AntonPower/Temp_Hum_Sensor_Cube/README.md

# Temp. Hum. Sensor Cube

Firmware für einen ESP-12 mit TH06/Si7006-Sensor. Der Cube misst Temperatur und
Luftfeuchtigkeit, speichert den Verlauf der letzten 7 Tage und zeigt die Temperatur auf
Tastendruck 10 s lang über eine RGB-LED an.

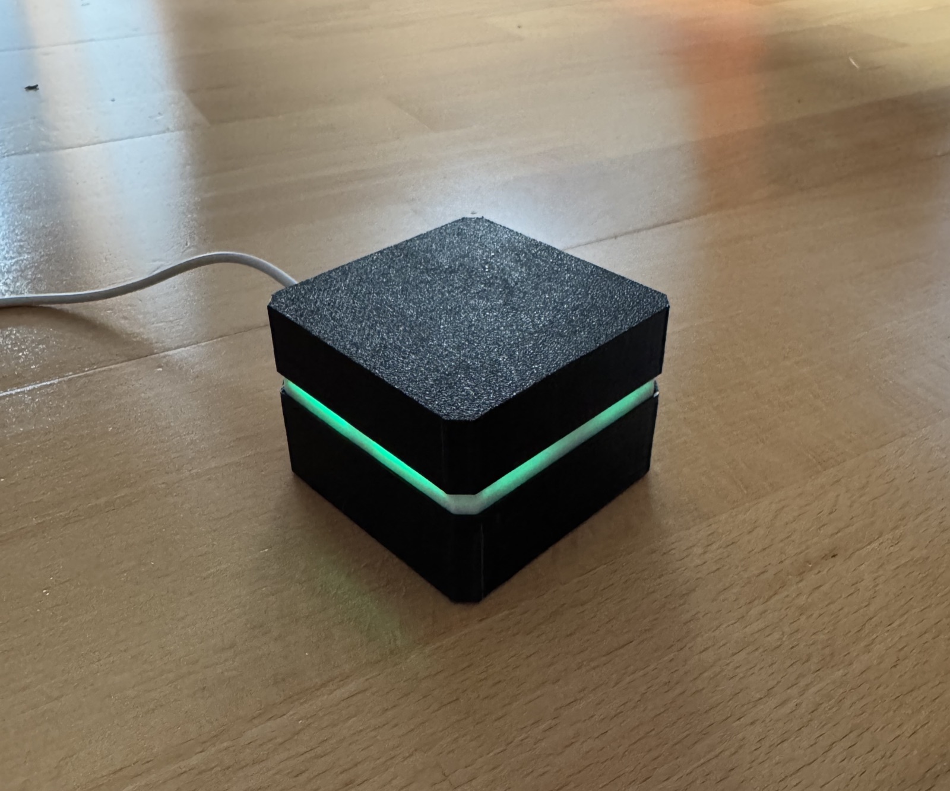
[picture p1: bilder/Cube_fertig_front.jpg]
Fertiger Sensor Cube


## Hardware

| Ordner | Inhalt |
|---|---|
| [`SCH_and_PCB/`](SCH_and_PCB) | Schaltplan als PDF, Stückliste der Platine (BOM, CSV) und Gerber-Dateien der Platine V1.0 zum Bestellen (EasyEDA) |
| [`3D parts/`](3D%20parts) | Gehäuse in drei Teilen zum Drucken (`Sensor_Cube_bot.stl`, `Sensor_Cube_middle.stl`, `Sensor_Cube_top.stl`) und das 3D-Modell der bestückten Platine (`3D_Model _V1.0 PCB.obj`) |
| [`bilder/`](bilder) | Fotos der Platine, vom Zusammenbau und vom fertigen Cube |

Das EasyEDA-Projekt mit Schaltplan und Platinenlayout ist öffentlich auf OSHWLab:
[oshwlab.com/antonpower48/temp_hum-sensor](https://oshwlab.com/antonpower48/temp_hum-sensor)

Die Platine hat einen ESP-12, den Sensor TH06/Si7006, eine RGB-LED, einen Taster,
einen Spannungsregler AMS1117-3.3 und eine Micro-USB-Buchse zur Versorgung. Die
vollständige Bauteilliste steht in der BOM.

Für die Gerber-Dateien den Ordner `Gerber_…` als ZIP packen und beim Platinenhersteller
hochladen, eine Anleitung steht in `How-to-order-PCB.txt`.

### Diode in der roten LED-Leitung (nur V1)

Bei der Platine V1 muss eine Diode 1N4148 (oder 1N400x) nachträglich eingelötet werden,
in Reihe in der roten Leitung zwischen LED und GPIO12, Kathode (Ring) zum ESP.

Warum: Die Anoden der RGB-LED hängen über je 100 Ω an 5 V, die LED ist LOW-aktiv. Zum
Ausschalten legt der ESP den Pin auf HIGH, das sind aber nur 3,3 V. Über der roten LED
bleiben so etwa 1,7 V, sie glimmt rot/orange, und GPIO12 bekommt dauerhaft Strom von den
5 V ab. Die Diode schluckt etwa 0,7 V, damit ist das Glimmen im Gehäuse nicht mehr zu
sehen und Rot wird kaum dunkler. Grün und Blau brauchen keine Diode, weil ihre
Flussspannung bei etwa 3 V liegt. An der Software ändert sich nichts.

### Teile für den Zusammenbau

Neben der bestückten Platine und den drei gedruckten Gehäuseteilen:

| Anzahl | Teil |
|---|---|
| 2 | Zylinderschraube mit Innensechskant M4 x 10 mm |
| 4 | Zylinderschraube mit Innensechskant M4 x 20 mm |
| 4 | Druckfeder 7/32" x 11/16" |
| 1 | Diode 1N4148 oder 1N400x (nur V1, siehe oben) |

| Teile vor dem Zusammenbau | Platine im Gehäuse, Federn im Deckel |
|---|---|
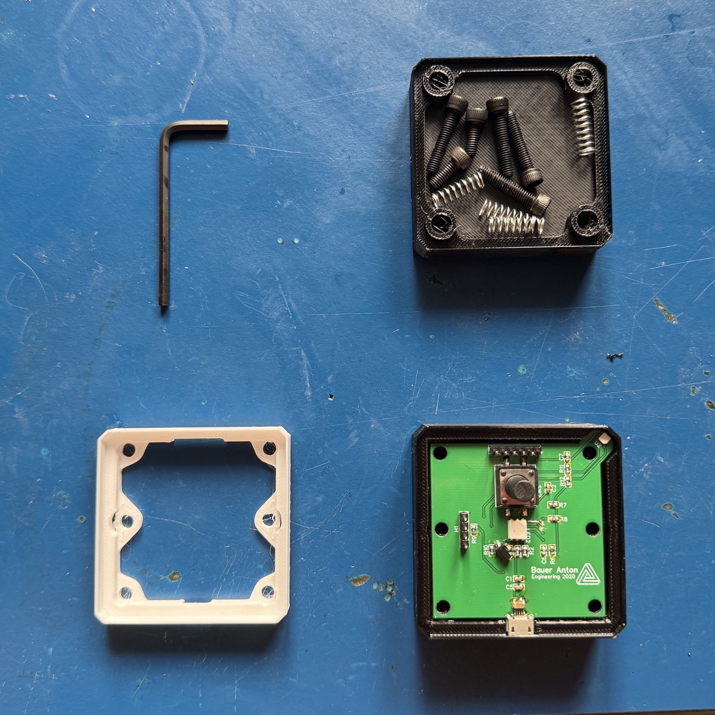
[picture p2: bilder/Cube_im_zusammenbau1.jpg]
Teile vor dem Zusammenbau
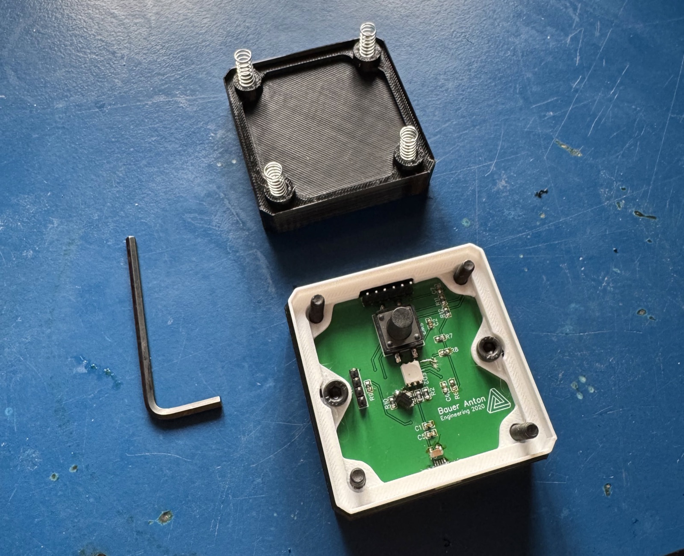
[picture p3: bilder/Cube_im_zusammenbau2.jpg]
Platine im Gehäuse
|  |  |

| Fertiger Cube | Fertiger Cube mit USB-Kabel |
|---|---|
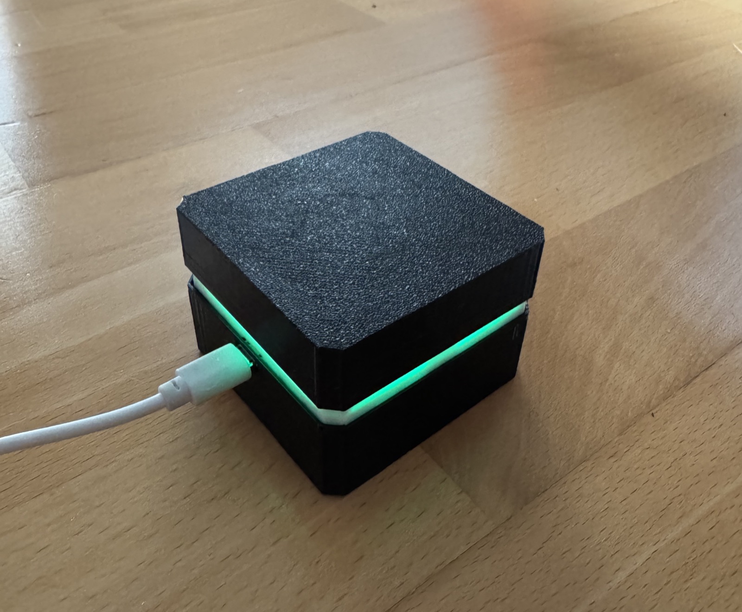
[picture p4: bilder/Cube_fertig_back.jpg]
Fertiger Cube mit USB-Kabel
| Fertiger Cube |  |

| Platine Vorderseite | Platine Rückseite | Platine mit LED |
|---|---|---|
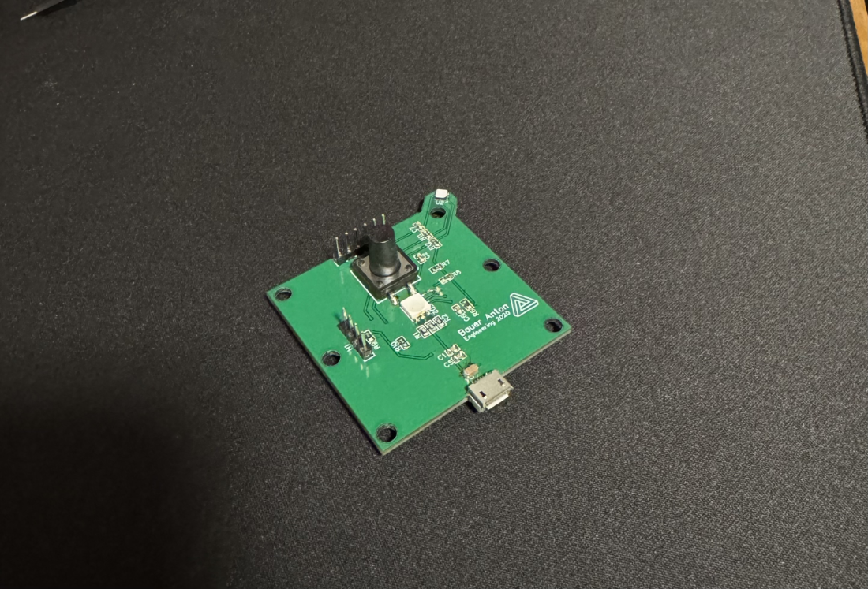
[picture p5: bilder/Board_front.png]
Platine Vorderseite
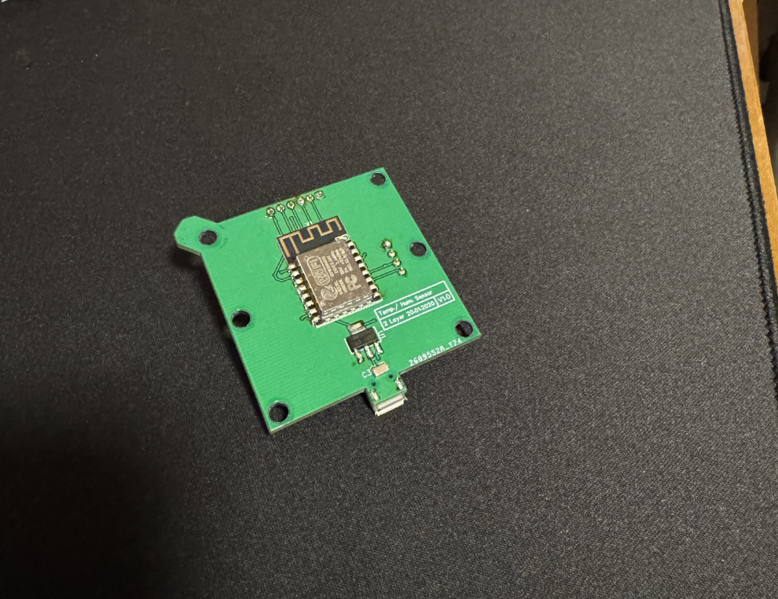
[picture p6: bilder/Board_back.png]
Platine Rückseite
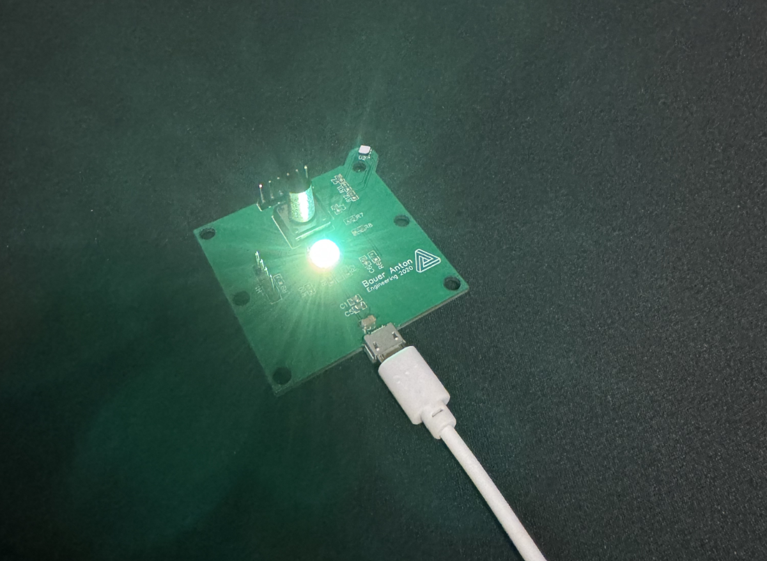
[picture p7: bilder/Board_led.png]
Platine mit leuchtender LED
|  |  |  |

## Bauen und Flashen

Das Projekt nutzt [PlatformIO](https://platformio.org/) in VS Code.

```sh
pio run                 # bauen
pio run -t upload       # flashen
pio device monitor      # serielle Ausgabe (115200 Baud)
```

## Pinbelegung

| Funktion | GPIO |
|---|---|
| I2C SDA / SCL (Sensor) | 4 / 5 |
| LED R / G / B | 12 / 14 / 16 |
| Taster (low-aktiv) | 13 |
| TM1637 CLK / DIO (V1 ungenutzt) | 2 / 0 |

## Stand

- [x] Messung über I2C, Ausgabe über Serial
- [x] LED-Farbverlauf und Taster (kurz drücken: Temperatur 10 s anzeigen, 2 s halten: Einstellungsmodus)
- [x] Einstellungsmodus per Browser
- [x] Verlauf der letzten 7 Tage und Stromsparen

## Einstellungen

Taster 2 s halten: Die LED blinkt langsam violett, und der Cube öffnet das eigene WLAN
`SensorCube` (Passwort `sensorcube`) mit der Seite unter `http://192.168.4.1`.
Dort Werte eintragen und speichern. Ein kurzer Druck oder nochmals 2 s halten beendet den Modus ohne Speichern, ebenso 5 Minuten
ohne geöffnete Einstellungsseite.

## Verlauf und Stromsparen

Der Cube bildet alle 10 Minuten einen Mittelwert, hält die letzten 7 Tage im RAM
und sichert sie stündlich in den Flash (LittleFS). Das WLAN bleibt dabei aus,
zwischen den Messungen schläft er im Light-Sleep, ein Tastendruck weckt ihn
sofort auf.

Beim Öffnen der Seite übernimmt der Cube die Uhrzeit des Handys. Kennt er sie beim
Sichern, weiß er nach einem Stromausfall, wie lange er aus war, sobald die Seite
wieder geöffnet wird, und trägt die Zeit als Lücke im Verlauf ein. Ohne Uhrzeit
läuft der Verlauf ohne Lücke weiter.

Die Diagramme stehen oben auf der Einstellungsseite. Die Zeitachse rechnet die
Seite mit der Uhr des Geräts aus, auf dem sie geöffnet ist.
