AntonPower/Temp_Hum_Sensor_Cube/SCH_and_PCB/BOM_Temp_Hum-Sensor_2026-10-26.csv

ID | Name | Designator | Footprint | Quantity | Manufacturer Part | Manufacturer | Supplier | Supplier Part | Price
1 | 10uF | C3,C4 | C0603 | 2
2 | ESP-12 | X1 | ESP-12 | 1
3 | AMS1117-3.3 | U1 | SOT-223_L6.7-W3.5-P2.30-BR | 1
4 | A2541WV-6P | H2 | HDR-TH_6P-P2.54-V | 1
5 | MHP5050RGBDT | LED2 | LED-ARRAY-SMD_6P-L5.0-W5.0-TR-RD | 1
6 | TS-1103S-C-U | SW2 | SW-SMD_4P-L12.0-W12.0-P5.00-LS15.4 | 1
7 | MICRO5.9MMUSB | USB1 | MICRO-USB-SMD_5PIN-H-FEMALE-PITCH0.65-L_MICRO5.9MMUSB | 1
8 | A2541WV-4P | H1 | HDR-TH_4P-P2.54-V | 1
9 | 100nF | C1,C2,C5,C6,C7 | 0603 | 5
10 | 100 | R1,R2,R3 | R0603 | 3
11 | 10K | R6,R7,R8,R9,R10,R11,R12 | R0603 | 7
12 | TH06 SI7006 | U2 | DFN-6_L3.0-W3.0-P1.00-BL-EP | 1
