AntonPower/Temp_Hum_Sensor_Cube/3D parts/Sensor_Cube_top.stl

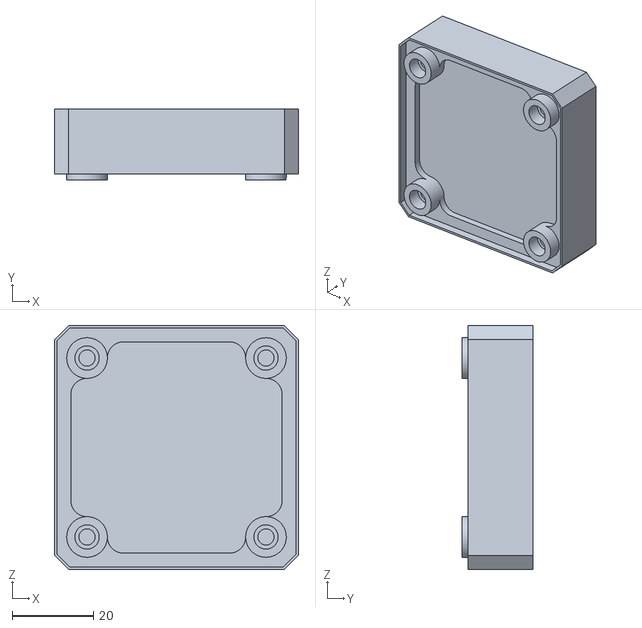
[picture p8: CAD file, 2026-10-27]
3D parts/Sensor_Cube_top.stl
60.0 x 17.5 x 60.0
