AntonPower/Temp_Hum_Sensor_Cube/3D parts/3D_Model _V1.0 PCB.obj

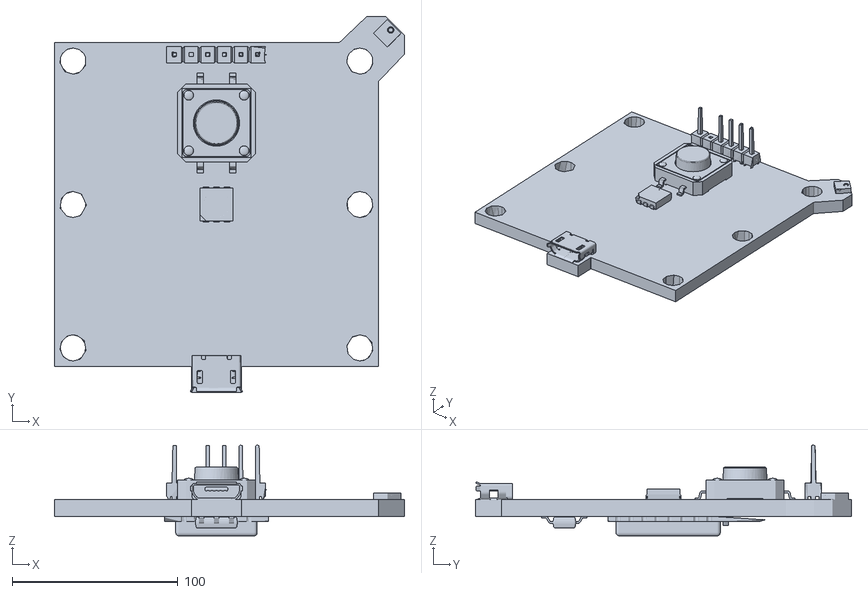
[picture p9: CAD file, 2026-10-27]
3D parts/3D_Model _V1.0 PCB.obj
211.4 x 227.1 x 54.9
