AntonPower/Temp_Hum_Sensor_Cube/3D parts/Sensor_Cube_middle.stl

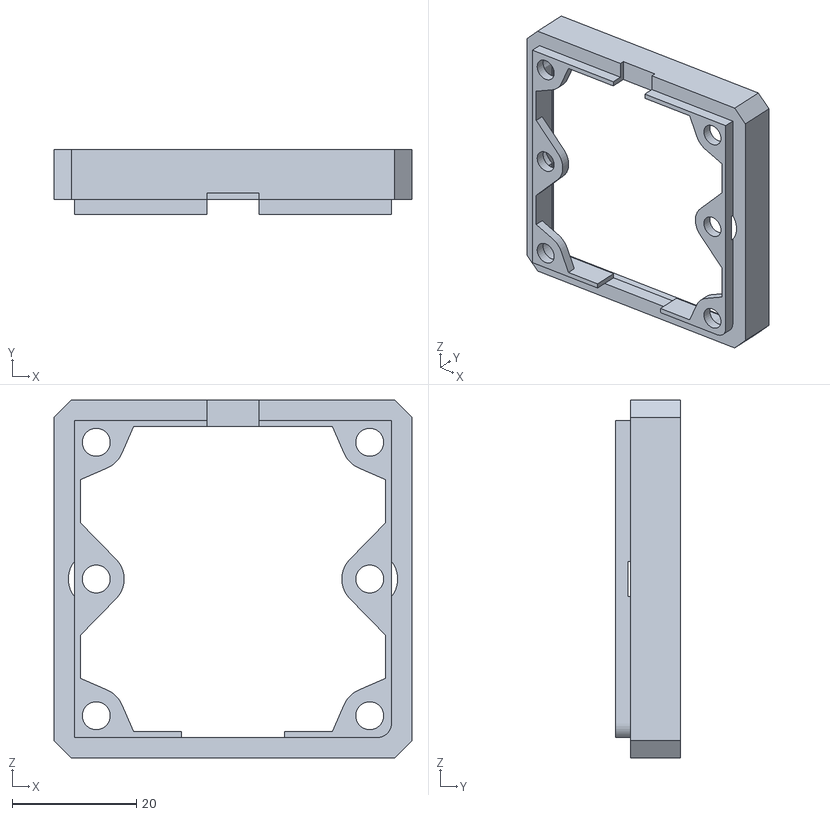
[picture p10: CAD file, 2026-10-27]
3D parts/Sensor_Cube_middle.stl
57.6 x 10.4 x 57.6
