AntonPower/Temp_Hum_Sensor_Cube/3D parts/Sensor_Cube_bot.stl

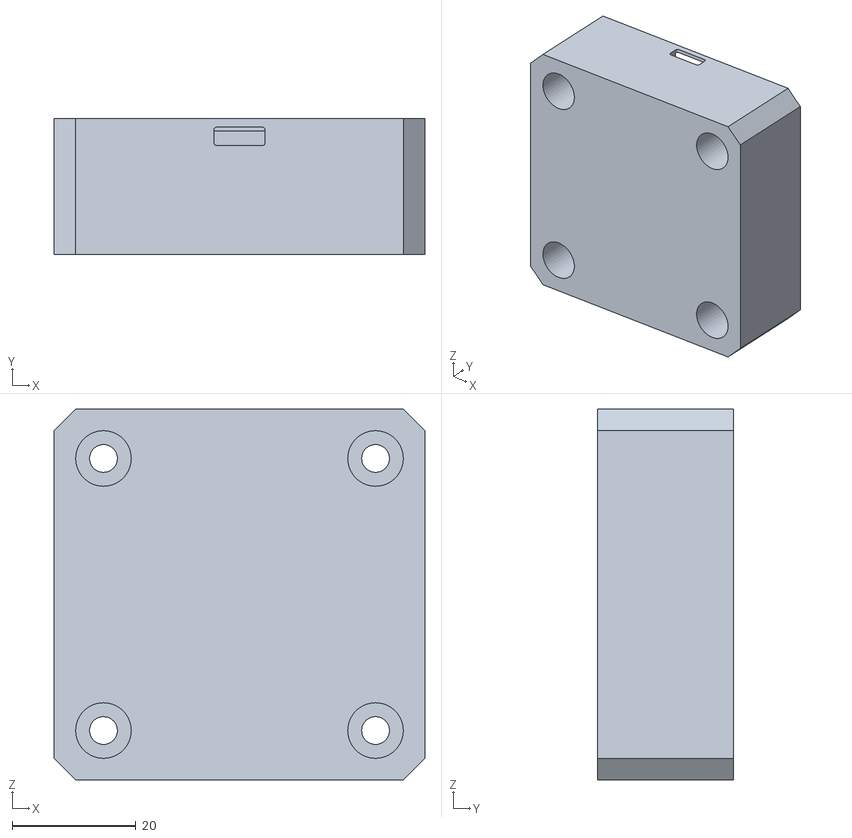
[picture p11: CAD file, 2026-10-27]
3D parts/Sensor_Cube_bot.stl
60.0 x 22.0 x 60.0
