AntonPower/Temp_Hum_Sensor_Cube/SCH_and_PCB/Gerber_Temp_Hum-Sensor_Temp_Hum-Sensorcube-V1.0-PCB/How-to-order-PCB.txt

How to Order PCB

Please refer to:
https://docs.easyeda.com/en/PCB/Order-PCB
