AntonPower/Temp_Hum_Sensor_Cube/SCH_and_PCB/Schematic_Temp_Hum_Sensor_Cube_2026-10-26.pdf

C

# Programmierung

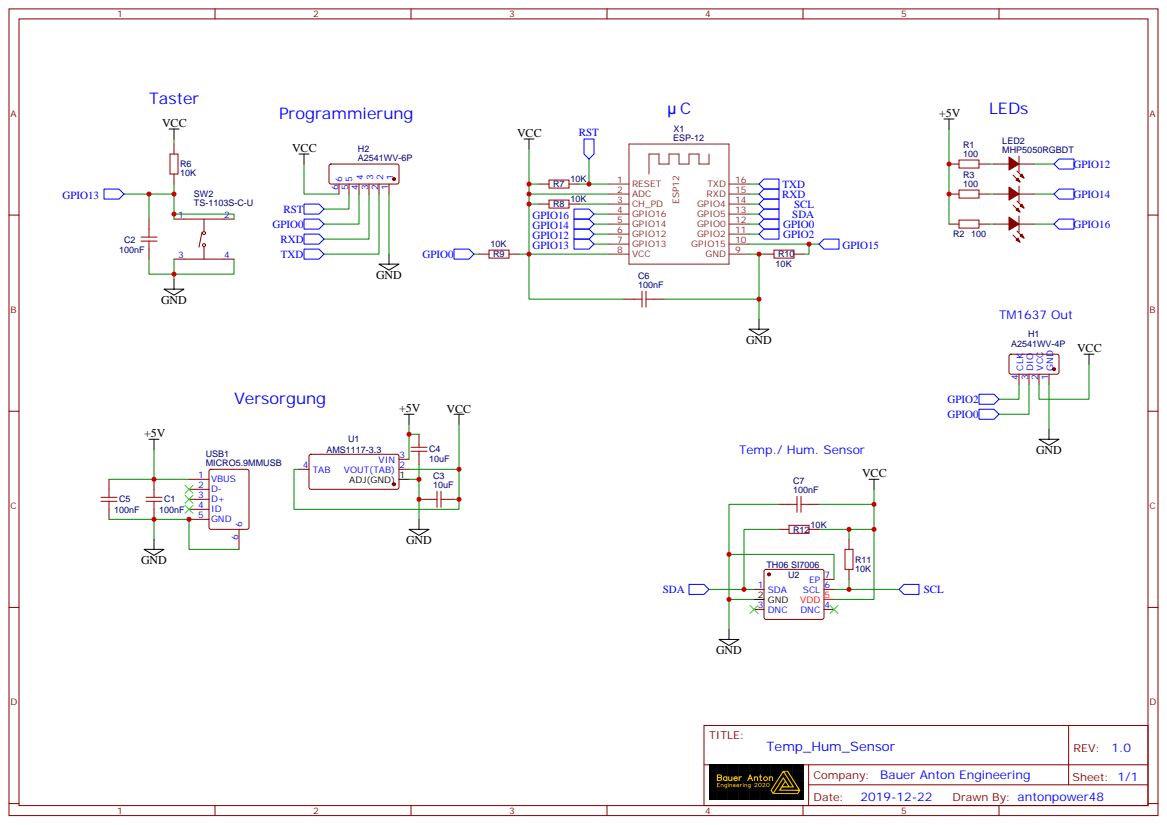
[picture p12: page 1]

Company: Bauer Anton Engineering
