AntonPower/Temp_Hum_Sensor_Cube/src/SettingsPortal.cpp

#include "SettingsPortal.h"

#include <DNSServer.h>
#include <ESP8266WebServer.h>
#include <ESP8266WiFi.h>
#include <LittleFS.h>

#include "Clock.h"
#include "History.h"
#include "TimeSync.h"
#include "Settings.h"
#include "config.h"

namespace SettingsPortal {
namespace {

ESP8266WebServer server(80);
DNSServer dns;
bool running = false;
uint32_t startedAt = 0;
float currentTemperature = NAN;
float currentHumidity = NAN;

String field(const char *label, const char *name, const String &value,
             const char *type = "text", const char *extra = "") {
    String html = F("<label>");
    html += label;
    html += F("<input type=\"");
    html += type;
    html += F("\" name=\"");
    html += name;
    html += F("\" value=\"");
    html += value;
    html += F("\" ");
    html += extra;
    html += F("></label>");
    return html;
}

// Zahlenfeld, das nur während der Eingabe ein Textfeld ist, damit ein Komma geht.
// Bleibende Textfelder holt der Captive-Portal-Browser immer wieder in den Fokus.
const char *const DECIMAL_INPUT =
    "step=\"0.1\" inputmode=\"decimal\" onpointerdown=\"if(this.type=='number'){"
    "this.type='text';this.value=this.value.replace('.',',')}\" "
    "onblur=\"this.value=this.value.replace(',','.');this.type='number'\"";
// Nur ganze Zahlen, Tastatur ohne Komma und Punkt
const char *const INTEGER_INPUT =
    "step=\"1\" inputmode=\"numeric\" pattern=\"[0-9]*\" "
    "oninput=\"this.value=this.value.replace(/[^0-9]/g,'')\"";

// Zuletzt gewählte Diagrammansicht in Stunden (1, 24 oder 168), im Flash gemerkt
constexpr const char *VIEW_FILE = "/ansicht.txt";
uint16_t chartHours = 0;  // 0 = noch nicht geladen

bool validView(long hours) {
    return hours == 1 || hours == 24 || hours == 168;
}

uint16_t loadView() {
    if (chartHours == 0) {
        chartHours = 24;
        File f = LittleFS.open(VIEW_FILE, "r");
        if (f) {
            const long hours = f.readString().toInt();
            if (validView(hours)) {
                chartHours = hours;
            }
            f.close();
        }
    }
    return chartHours;
}

// Liest eine Kommazahl, Komma und Punkt sind gleichwertig
float decimalArg(const char *name) {
    String value = server.arg(name);
    value.replace(',', '.');
    return value.toFloat();
}

void sendPage(const String &body) {
    String html = F(
        "<!doctype html><html lang=\"de\"><head><meta charset=\"utf-8\">"
        "<meta name=\"viewport\" content=\"width=device-width,initial-scale=1\">"
        "<title>Sensor Cube</title><style>"
        "body{font-family:sans-serif;max-width:28em;margin:1em auto;padding:0 1em}"
        "label{display:block;margin:.8em 0}input{display:block;width:100%;"
        "box-sizing:border-box;padding:.4em;font-size:1em}"
        "button{margin-top:1em;padding:.6em 1.2em;font-size:1em}"
        "h2{margin-top:1.5em;font-size:1.1em}.now{font-size:2em;margin:.5em 0}"
        "canvas{width:100%;height:160px;display:block}.hint{color:#666}</style></head><body>"
        "<h1>Sensor Cube</h1>");
    html += body;
    html += F("</body></html>");
    server.send(200, F("text/html; charset=utf-8"), html);
}

String readingsJson() {
    String json = F("{\"t\":");
    json += isnan(currentTemperature) ? String("null") : String(currentTemperature, 2);
    json += F(",\"h\":");
    json += isnan(currentHumidity) ? String("null") : String(currentHumidity, 1);
    json += '}';
    return json;
}

void handleReadings() {
    startedAt = millis();  // offene Seite hält den Modus am Leben
    server.send(200, F("application/json"), readingsJson());
}

// Uhrzeit des Handys übernehmen, damit der Cube Stromausfälle im Verlauf erkennt
void handleTime() {
    const bool wasKnown = TimeSync::known();
    if (TimeSync::set(strtoul(server.arg("e").c_str(), nullptr, 10)) && !wasKnown) {
        History::fillGapSinceRestore();
    }
    server.send(204);
}

// Verlauf als JSON, in Stücken gesendet, damit kein großer String im RAM entsteht
void handleHistory() {
    startedAt = millis();
    const size_t n = History::size();

    server.setContentLength(CONTENT_LENGTH_UNKNOWN);
    server.send(200, F("application/json"), "");

    String chunk = F("{\"step\":");
    chunk += String(History::STEP_S);
    chunk += F(",\"age\":");
    chunk += String(History::ageOfNewestS(Clock::now()));
    for (uint8_t series = 0; series < 2; series++) {
        chunk += series == 0 ? F(",\"t\":[") : F("],\"h\":[");
        for (size_t i = 0; i < n; i++) {
            const float v = series == 0 ? History::temperatureAt(i) : History::humidityAt(i);
            if (i > 0) {
                chunk += ',';
            }
            chunk += isnan(v) ? String("null") : String(v, series == 0 ? 2 : 1);
            if (chunk.length() > 1000) {
                server.sendContent(chunk);
                chunk = "";
            }
        }
    }
    // Manuelle Punkte als [Alter in s, Temperatur, Feuchte]
    chunk += F("],\"m\":[");
    for (size_t i = 0; i < History::manualSize(); i++) {
        uint32_t ageS;
        float t, h;
        History::manualAt(i, Clock::now(), ageS, t, h);
        if (i > 0) {
            chunk += ',';
        }
        chunk += '[';
        chunk += String(ageS);
        chunk += ',';
        chunk += String(t, 2);
        chunk += ',';
        chunk += String(h, 1);
        chunk += ']';
        if (chunk.length() > 1000) {
            server.sendContent(chunk);
            chunk = "";
        }
    }
    chunk += F("]}");
    server.sendContent(chunk);
    server.sendContent("");
}

void handleRoot() {
    startedAt = millis();
    // Farbverlauf wie die LED: Wunsch ± Spanne von blau über grün bis rot.
    // Feuchte umgekehrt: trocken rot, feucht blau.
    String body = F("<script>var TG=");
    body += String(settings.targetTemperature, 1);
    body += F(",SP=");
    body += String(settings.temperatureSpan, 1);
    body += F(",HG=");
    body += String(settings.targetHumidity, 0);
    body += F(",HS=");
    body += String(settings.humiditySpan, 0);
    body += F(
        ";function grad(x){x=Math.max(-1,Math.min(1,x));"
        "var c=x<-.5?[0,(x+1)*2,1]:x<0?[0,1,-x*2]:x<.5?[x*2,1,0]:[1,(1-x)*2,0];"
        // etwas abgedunkelt, damit Gelb und Cyan auf Weiß lesbar bleiben
        "return 'rgb('+c.map(function(v){return Math.round(v*200)})+')'}"
        "function col(t){return grad((t-TG)/SP)}function colH(h){return grad((HG-h)/HS)}</script>"
        "<p class=\"now\"><span id=\"t\">–</span> °C &nbsp; <span id=\"h\">–</span> %</p>"
        "<script>var L=null;function u(d){L=d;var a=document.activeElement;"
        "if(a&&a.tagName=='INPUT')return;"
        "var e=document.getElementById('t');"
        "e.textContent=d.t===null?'–':d.t.toFixed(1);e.style.color=d.t===null?'':col(d.t);"
        "e=document.getElementById('h');e.textContent=d.h===null?'–':d.h.toFixed(0);"
        "e.style.color=d.h===null?'':colH(d.h)}u(");
    body += readingsJson();
    body += F(");setInterval(function(){fetch('/werte').then(function(r){return r.json()})"
              ".then(u).catch(function(){})},10000)</script>");
    body += F(
        "<p><button id=\"b1\" onclick=\"pick(1)\">1 Stunde</button> "
        "<button id=\"b24\" onclick=\"pick(24)\">1 Tag</button> "
        "<button id=\"b168\" onclick=\"pick(168)\">7 Tage</button></p>"
        "<h2>Temperatur</h2><canvas id=\"ct\"></canvas>"
        "<h2>Luftfeuchte</h2><canvas id=\"ch\"></canvas>"
        "<p class=\"hint\" id=\"hi\"></p>"
        "<script>fetch('/zeit?e='+Math.floor(Date.now()/1000)).catch(function(){});"
        "var D=null,hours=");
    body += String(loadView());
    body += F(";"
        // Alle Punkte des Zeitraums nach Zeit sortiert: [Zeit, Wert].
        // Zeitachse aus der Uhr des Handys: Mittelwert i endet vor age + (n-1-i)*step Sekunden
        "function series(k,t0,now){var d=D,v=d[k],n=v.length,p=[];"
        "for(var i=0;i<n;i++){var t=now-(d.age+(n-1-i)*d.step+d.step/2)*1000;"
        "if(t>=t0)p.push([t,v[i]])}"
        "d.m.forEach(function(m){var t=now-m[0]*1000;if(t>=t0)p.push([t,m[k=='t'?1:2]])});"
        "return p.sort(function(a,b){return a[0]-b[0]})}"
        "function draw(id,k,unit,f,cf){var c=document.getElementById(id),w=c.clientWidth,H=160,"
        "r=window.devicePixelRatio||1;c.width=w*r;c.height=H*r;var g=c.getContext('2d');g.scale(r,r);"
        "g.font='11px sans-serif';var now=Date.now(),span=hours*36e5,t0=now-span,L=40,B=16,"
        "x=function(t){return L+(t-t0)/span*(w-L-6)},p=series(k,t0,now),lo=1e9,hi=-1e9;"
        // Achse vom niedrigsten bis zum höchsten Wert im sichtbaren Zeitraum
        "p.forEach(function(q){if(q[1]!==null){lo=Math.min(lo,q[1]);hi=Math.max(hi,q[1])}});"
        "if(lo>hi){g.fillStyle='#666';g.fillText('Noch keine Daten',L,H/2);return}"
        "var pad=hi-lo<.2?.1:0,a0=lo-pad,a1=hi+pad,y=function(a){return 6+(a1-a)/(a1-a0)*(H-B-12)};"
        // Raster: 1 Stunde alle 10 min, 1 Tag alle 3 h, 7 Tage um Mitternacht
        "g.strokeStyle='#ddd';g.fillStyle='#666';var gm=hours==1?10:hours==24?180:1440,m=new Date(t0);"
        "m.setSeconds(0,0);var mm=m.getHours()*60+m.getMinutes();m.setHours(0,Math.ceil(mm/gm)*gm);"
        "for(;m.getTime()<now;m.setMinutes(m.getMinutes()+gm)){var X=x(m.getTime());g.beginPath();"
        "g.moveTo(X,4);g.lineTo(X,H-B);g.stroke();if(X<w-30)g.fillText(hours==1?m.getHours()+':'+"
        "('0'+m.getMinutes()).slice(-2):hours==24?m.getHours()+' h':"
        "m.toLocaleDateString('de-DE',{weekday:'short'}),X+2,H-4)}"
        "g.fillStyle=cf(hi);g.fillText(hi.toFixed(f)+unit,0,y(hi)+4);"
        "g.fillStyle=cf(lo);g.fillText(lo.toFixed(f)+unit,0,y(lo)+4);"
        // Feine Linie, jedes Stück in der Farbe seines Werts, Lücken unterbrechen sie
        "g.lineWidth=1;for(var i=1;i<p.length;i++){var a=p[i-1],b=p[i];"
        "if(a[1]===null||b[1]===null)continue;g.strokeStyle=cf((a[1]+b[1])/2);g.beginPath();"
        "g.moveTo(x(a[0]),y(a[1]));g.lineTo(x(b[0]),y(b[1]));g.stroke()}"
        // Punkt an jeder Messung, bei dichten Punkten (7 Tage) kleiner
        "var R=Math.max(1,Math.min(2.5,(w-L)/p.length/2));p.forEach(function(q){if(q[1]===null)return;"
        "g.fillStyle=cf(q[1]);g.beginPath();g.arc(x(q[0]),y(q[1]),R,0,7);g.fill()})}"
        "function pick(n){show(n);fetch('/ansicht?h='+n).catch(function(){})}"
        "function show(n){hours=n;[1,24,168].forEach(function(b){"
        "document.getElementById('b'+b).disabled=b==n});if(!D)return;"
        "draw('ct','t','°',1,col);draw('ch','h','%',0,colH)}"
        "fetch('/verlauf').then(function(r){return r.json()}).then(function(d){D=d;show(hours);"
        "document.getElementById('hi').textContent=d.t.length?"
        "Math.round(d.t.length*d.step/3600)+' h gespeichert.':''})"
        "</script>");
    // Speichern im Hintergrund, die Seite bleibt stehen. Ohne JavaScript normales Absenden.
    body += F(
        "<script>function save(f){var a=document.activeElement;if(a&&a.blur)a.blur();"
        "var e=f.elements,b=new URLSearchParams(new FormData(f)),o=document.getElementById('ok');"
        "b.append('js','1');o.textContent='…';"
        "fetch('/save',{method:'POST',body:b}).then(function(r){if(!r.ok)throw 0;"
        "var n=function(k){return parseFloat(e[k].value.replace(',','.'))};"
        "TG=n('target');SP=n('span');HG=n('htarget');HS=n('hspan');"
        "o.textContent='✓ Gespeichert';setTimeout(function(){o.textContent=''},4000);"
        "if(L)u(L);if(D)show(hours)}).catch(function(){o.textContent='Speichern fehlgeschlagen'});"
        "return false}</script>"
        "<form method=\"post\" action=\"/save\" onsubmit=\"return save(this)\">"
        "<h2>Messung und Anzeige</h2>");
    body += field("Messintervall in Sekunden (10 bis 600), im Diagramm gemittelt alle 10 min",
                  "interval", String(settings.measureIntervalS), "number", INTEGER_INPUT);
    body += field("Wunschtemperatur in °C (grün)", "target",
                  String(settings.targetTemperature, 1), "number", DECIMAL_INPUT);
    body += field("Spanne in °C (ab Wunsch ± Spanne voll blau/rot)", "span",
                  String(settings.temperatureSpan, 1), "number", DECIMAL_INPUT);
    body += field("Wunsch-Luftfeuchte in % (grün im Diagramm)", "htarget",
                  String(settings.targetHumidity, 0), "number", INTEGER_INPUT);
    body += field("Spanne in % (ab Wunsch ± Spanne voll rot/blau)", "hspan",
                  String(settings.humiditySpan, 0), "number", INTEGER_INPUT);
    body += F("<button type=\"submit\">Speichern</button> <span id=\"ok\"></span></form>");
    body += F(
        "<p class=\"hint\">Info: Genauigkeit des Sensors (TH06C) laut Datenblatt: Temperatur "
        "typisch ±0,5 °C, höchstens ±1 °C (−10 bis 85 °C). Luftfeuchte typisch ±4 %, "
        "höchstens ±5 % (bei 0 bis 80 %).</p>");
    sendPage(body);
}

void handleSave() {
    startedAt = millis();
    // Höchstens 10 Minuten, damit jeder Punkt im Verlauf mindestens eine Messung hat
    settings.measureIntervalS = constrain(server.arg("interval").toInt(), 10L, 600L);
    settings.targetTemperature = decimalArg("target");
    settings.temperatureSpan = max(0.1f, decimalArg("span"));
    settings.targetHumidity = constrain(server.arg("htarget").toInt(), 0L, 100L);
    settings.humiditySpan = max(1L, server.arg("hspan").toInt());
    settings.save();

    // Kein Neustart, sonst ginge der Verlauf im RAM verloren
    Serial.println("Einstellungen gespeichert");
    if (server.arg("js") == "1") {
        server.send(204);
        return;
    }
    sendPage(F("<p>Gespeichert.</p><script>setTimeout(function(){location.href='/'},1500)"
               "</script><p><a href=\"/\">Zurück</a></p>"));
}

void handleView() {
    startedAt = millis();
    const long hours = server.arg("h").toInt();
    if (validView(hours) && hours != loadView()) {
        chartHours = hours;
        File f = LittleFS.open(VIEW_FILE, "w");
        if (f) {
            f.print(hours);
            f.close();
        }
    }
    server.send(204);
}

void handleNotFound() {
    // Captive Portal: jede Adresse führt auf die Einstellungsseite
    server.sendHeader(F("Location"), F("http://192.168.4.1/"));
    server.send(302);
}

}  // namespace

void setReadings(float temperature, float humidity) {
    currentTemperature = temperature;
    currentHumidity = humidity;
}

void start() {
    // Eigener Access Point mit Captive Portal
    WiFi.forceSleepWake();
    delay(1);
    WiFi.mode(WIFI_AP);
    WiFi.softAP(SETTINGS_AP_SSID, SETTINGS_AP_PASSWORD);
    dns.start(53, "*", WiFi.softAPIP());
    Serial.printf("Einstellungsmodus: WLAN \"%s\", http://%s\n", SETTINGS_AP_SSID,
                  WiFi.softAPIP().toString().c_str());

    server.on("/", HTTP_GET, handleRoot);
    server.on("/save", HTTP_POST, handleSave);
    server.on("/werte", HTTP_GET, handleReadings);
    server.on("/verlauf", HTTP_GET, handleHistory);
    server.on("/zeit", HTTP_GET, handleTime);
    server.on("/ansicht", HTTP_GET, handleView);
    server.onNotFound(handleNotFound);
    server.begin();

    running = true;
    startedAt = millis();
}

void stop() {
    server.stop();
    dns.stop();
    WiFi.softAPdisconnect(true);
    WiFi.mode(WIFI_OFF);
    WiFi.forceSleepBegin();
    running = false;
    Serial.println("Einstellungsmodus beendet");
}

bool active() {
    return running;
}

void handle() {
    dns.processNextRequest();
    server.handleClient();
    if (millis() - startedAt >= SETTINGS_TIMEOUT_MS) {
        stop();
    }
}

}  // namespace SettingsPortal
