AntonPower/Temp_Hum_Sensor_Cube/include/Settings.h

#pragma once

#include <Arduino.h>

// Dauerhaft im Flash gespeicherte Einstellungen
struct Settings {
    uint32_t measureIntervalS;
    float targetTemperature;  // Wunschtemperatur = grün
    float temperatureSpan;    // ab Wunsch ± Spanne voll blau bzw. rot
    float targetHumidity;     // Wunschfeuchte = grün im Diagramm
    float humiditySpan;       // ab Wunsch ± Spanne voll rot (trocken) bzw. blau (feucht)

    void setDefaults();
    // Lädt aus dem Flash, bei ungültigen Daten Standardwerte
    void load();
    void save() const;
};

extern Settings settings;
