AntonPower/Temp_Hum_Sensor_Cube/(commit log)

2026-10-26 Si7006 per I2C auslesen und über Serial ausgeben
    Eigener kleiner Treiber für TH06/Si7006 mit CRC-Prüfung. WLAN bleibt
    nach dem Start ausgeschaltet.
    Claude-Session: https://claude.ai/code/session_01Q7PRDJ9kbkp5tWN7CZ7qX9
2026-10-26 Temperatur per RGB-LED anzeigen und Taster auswerten
    Kurzer Tastendruck zeigt die Temperatur 10 s lang als Farbverlauf
    (blau, cyan, grün, gelb, rot) um die Wunschtemperatur. Ein langer Druck
    (3 s) ist für den Einstellungsmodus reserviert. Blau hängt an GPIO16 und
    kann nur an/aus geschaltet werden.
    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
2026-10-26 Einstellungsmodus mit eigenem WLAN und Weboberfläche
    Langer Tastendruck öffnet einen Access Point mit Einstellungsseite für
    WLAN, Volkszähler, Messintervall und Wunschtemperatur. Die Werte liegen
    mit Prüfsumme im Flash. Nach dem Speichern startet der Cube neu.
    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
2026-10-26 LED ist low-aktiv (gemeinsame Anode)
    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
2026-10-26 Aktuelle Messwerte auf der Einstellungsseite anzeigen
    Die Seite zeigt Temperatur und Feuchte und lädt sie alle 10 s über
    /werte nach. Im Einstellungsmodus misst der Cube dafür alle 10 s.
    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
2026-10-26 Zeitlimit im Einstellungsmodus bei offener Seite verlängern
    Die Seite fragt alle 10 s die Messwerte ab. Jede Anfrage startet die
    10 Minuten neu, damit niemand beim Eintippen herausfliegt.
    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
2026-10-26 Messwerte an Volkszähler senden und zwischen den Messungen schlafen
    Bei jeder regulären Messung verbindet sich der Cube kurz mit dem WLAN,
    sendet beide Werte an die Middleware und schaltet das WLAN wieder ab.
    Dazwischen geht er in den Forced Light-Sleep, der Taster weckt auf.
    Dazu eine Anleitung zum Aufsetzen von Volkszähler.
    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
2026-10-26 Volkszähler-Anleitung: Links und Kanaltypen allgemeiner fassen
    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
2026-10-26 Verlauf der letzten 7 Tage auf dem Cube statt Volkszähler
    Anton hat keinen Server und will den Verlauf nur lokal sehen. Der Cube
    speichert alle 10 Minuten einen Mittelwert im RAM (1008 Punkte) und
    zeigt Temperatur und Feuchte als Diagramm auf der Einstellungsseite.
    Die Zeitachse kommt von der Uhr des Handys. Clock trägt die Zeit im
    Light-Sleep nach, die millis() nicht zählt. Speichern startet nicht mehr
    neu, damit der Verlauf erhalten bleibt.
    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
2026-10-26 Heim-WLAN auf Knopfdruck, Uhrzeit per NTP, Verlauf im Flash sichern
    Ein langer Tastendruck verbindet den Cube für 5 Minuten mit dem
    Heim-WLAN (http://sensorcube.local per mDNS), sonst wie bisher eigenes
    WLAN. Beim Start und täglich holt er kurz die Uhrzeit. Der Verlauf
    wird stündlich in LittleFS gesichert und nach einem Stromausfall um die
    fehlende Zeit als Lücke ergänzt.
    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
2026-10-26 Vorzeichen-Warnung beim Laden des Verlaufs beheben
    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
2026-10-26 Light-Sleep: Taster weckt sofort, Modem-Sleep vorher schließen
    Nach dem Wecken per Taster lief delay() bis zum Ende der Schlafzeit weiter,
    der Taster wurde bis zu einem Messintervall ignoriert.
    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
2026-10-26 Nur eigenes WLAN, Uhrzeit vom Browser statt NTP
    Anton möchte den Cube nicht im Heimnetz haben. Heim-WLAN, mDNS und NTP sind
    raus. Die Seite schickt beim Öffnen die Uhrzeit des Handys, damit der Verlauf
    Stromausfälle weiterhin als Lücke erkennt.
    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
2026-10-26 Ein gemeinsames Diagramm, Temperatur in LED-Farben, Tastendruck-Punkte in der Linie
    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
2026-10-26 Hinweis zum Messintervall und den 10-Minuten-Punkten
    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
2026-10-26 Langer Druck 2 s, Zahlenfelder statt Textfelder, Sensorgenauigkeit auf der Seite
    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
2026-10-26 Komma in den Temperaturfeldern, Genauigkeit ans Seitenende
    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
2026-10-26 Feuchte ganzzahlig, kein Springen in Felder, Ansicht gemerkt, Rücksprung nach Speichern
    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
2026-10-27 Hardware-Dateien und Stückliste für den Zusammenbau ergänzen
    Schaltplan, BOM, Gerber, Gehäuse-STLs, PCB-3D-Modell und Fotos ins Repo,
    README um Abschnitt Hardware mit Teileliste erweitert.
    [3D_Model _V1.0 PCB.obj, BOM_Temp_Hum-Sensor_2026-10-26.csv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]
2026-10-27 README: Hinweis auf die Diode in der roten LED-Leitung bei V1
2026-10-27 README: Fotos vom Zusammenbau und vom fertigen Cube
